Chillwave/DB2194PH-selfPropelled-rearDriveWheel/test_slice_v2.stl

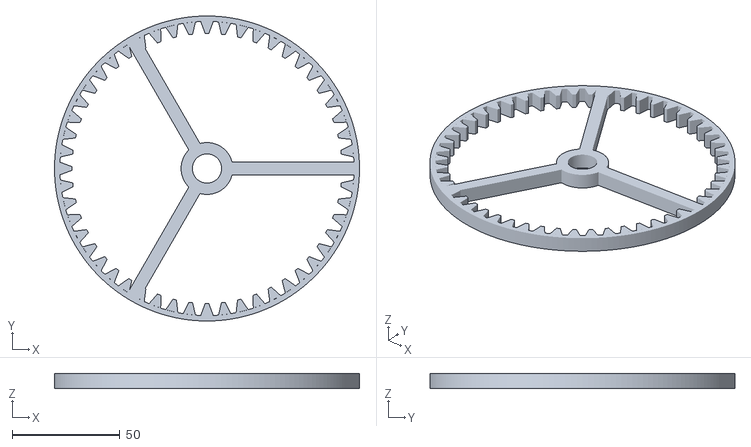
[picture p4: CAD file, 2026-10-09]
test_slice_v2.stl
141.2 x 141.2 x 7.00
