Chillwave/DB2194PH-selfPropelled-rearDriveWheel/spacer_11mm.stl

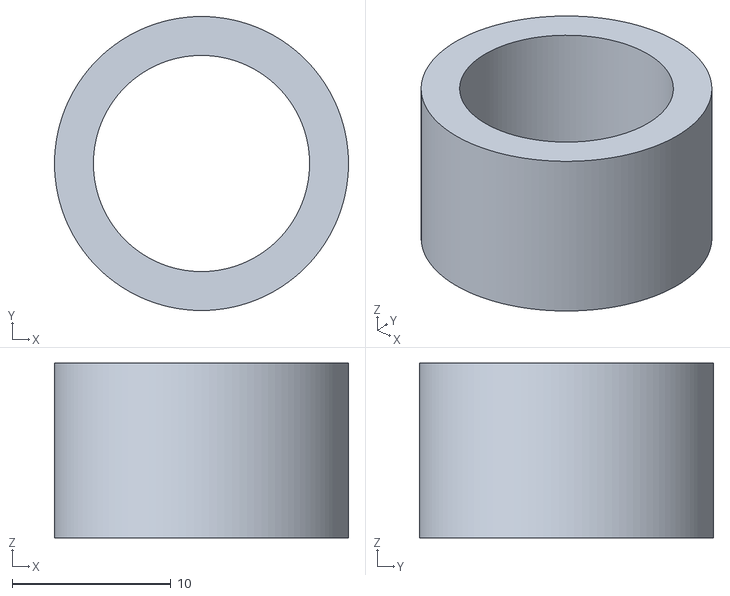
[picture p5: CAD file, 2026-10-09]
spacer_11mm.stl
18.5 x 18.5 x 11.0
