Chillwave/DB2194PH-selfPropelled-rearDriveWheel/wheel_v8.stl

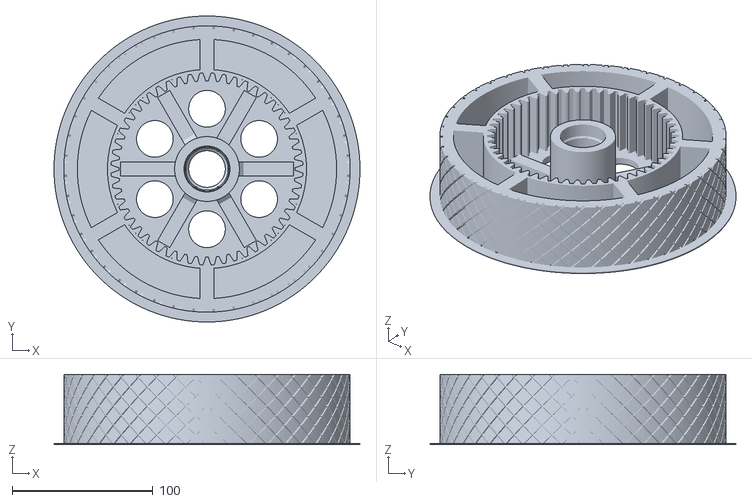
[picture p6: CAD file, 2026-10-09]
wheel_v8.stl
217.2 x 217.2 x 50.0
