Chillwave/DB2194PH-selfPropelled-rearDriveWheel/(commit log)

2026-07-07 v6 files
    [drive_wheel_v6.scad]
2026-10-09 v8 upload
    [drive_wheel_v8.scad, spacer.scad, spacer_11mm.stl, test_slice_v2.scad, test_slice_v2.stl, wheel_v8.stl]
